emilylinchan/led-spectrum/assets/flowchart.png

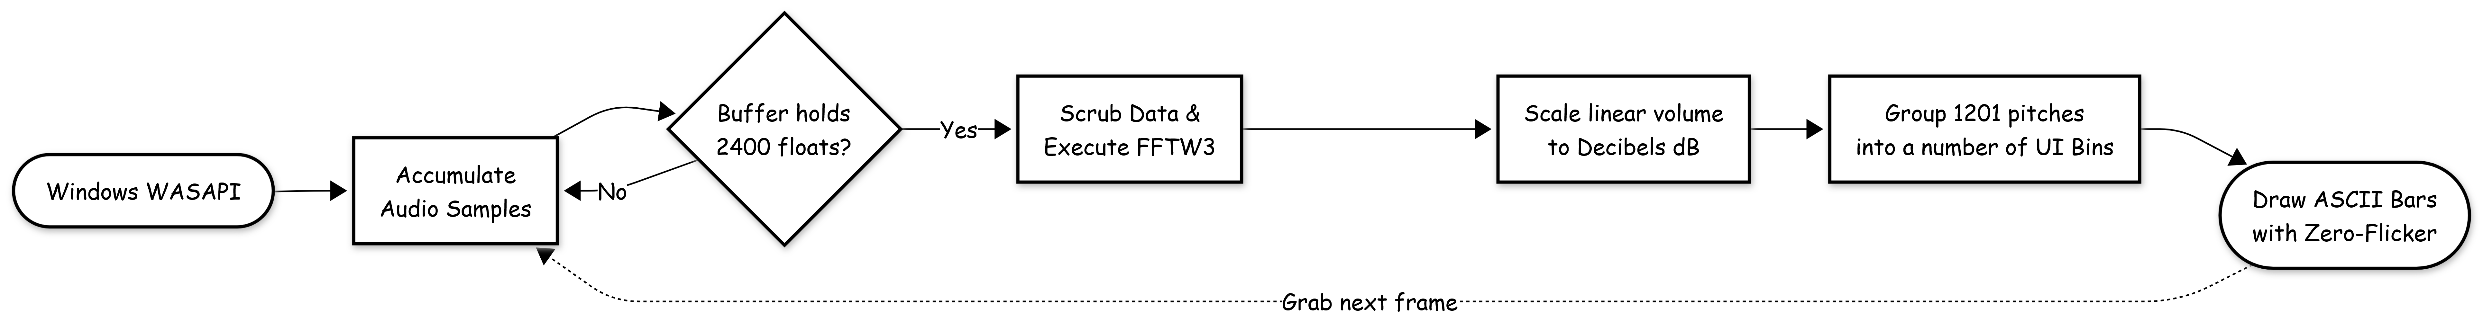
assets/flowchart.png
