emilylinchan/led-spectrum/assets/spectrum.gif

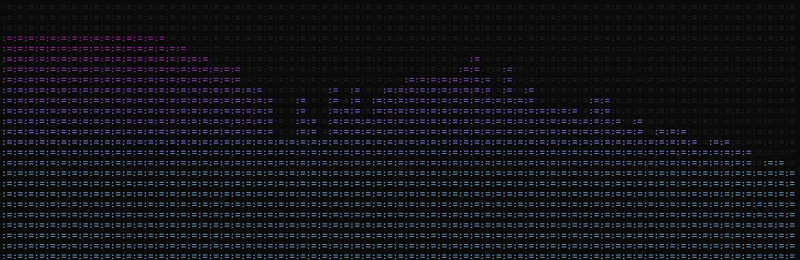
assets/spectrum.gif
