emilylinchan/led-spectrum/assets/spectrum.png

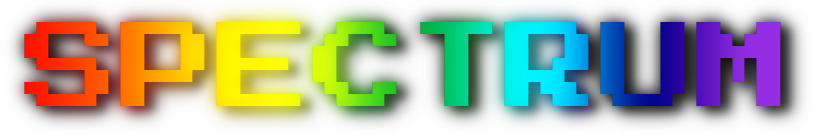
assets/spectrum.png
