emilylinchan/led-spectrum/hardware/images/custom_cable.png

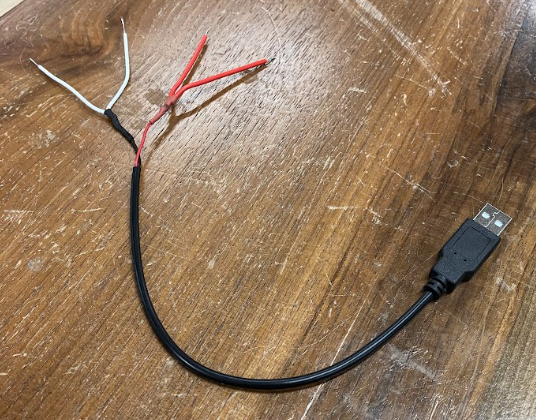
hardware/images/custom_cable.png
