emilylinchan/led-spectrum/(list of files, cad)

Other CAD files:
hardware/cad/led_spectrum_frame.ipt
