emilylinchan/led-spectrum/hardware/images/wiring_setup.png

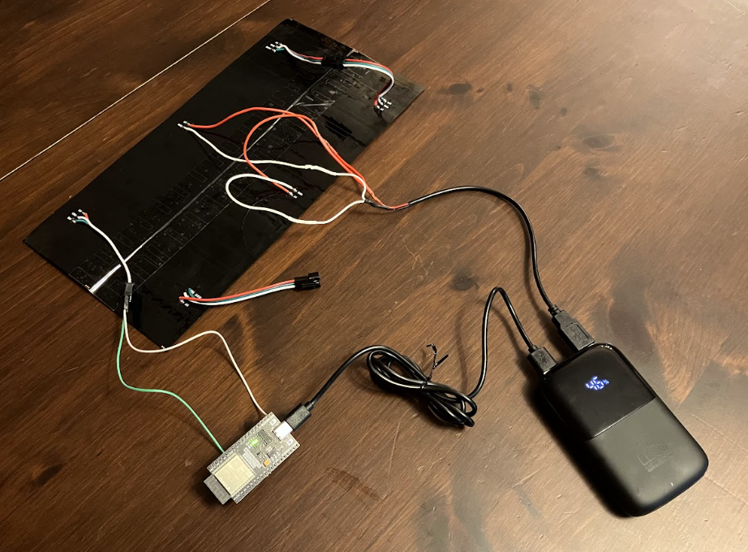
hardware/images/wiring_setup.png
