emilylinchan/led-spectrum/assets/discrete fast fourier transforms.pdf

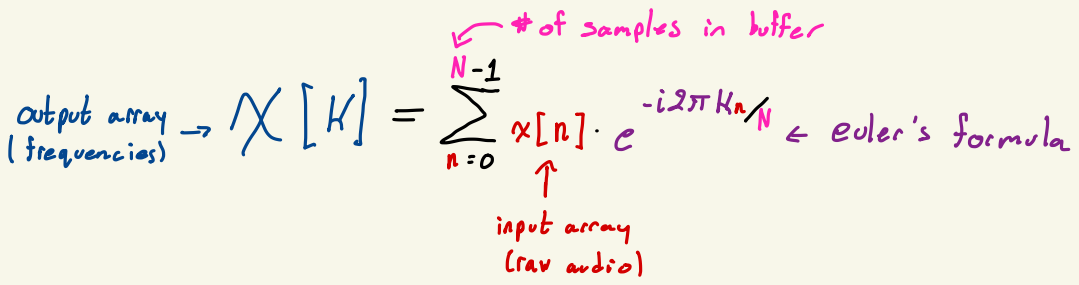
[picture p7: page 1]
## of samples in; buffer; outpet aray; requncia¹ → A ( N; ierthnN =; euler's formula; input array craw audiol
