emilylinchan/led-spectrum/src/main.cpp

/*
    Terminal Equalizer - A real-time command line audio visualizer
    Copyright (C) 2026 Majock Bim

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
    You should have received a copy of the GNU General Public License
    along with this program.  If not, see <https://www.gnu.org/licenses/>.
*/

#include "../inc/main.hpp"

#define AsciiRgb(k, r, g, b) "\033[" #k ";2;" #r ";" #g ";" #b "m"

std::atomic<bool> keepRunning(true);

void signalHandler(_In_ int signum) {
    keepRunning = false;
    AudioEngine::Get().Stop();
}

int __cdecl main(void) {
    SetConsoleOutputCP(CP_UTF8);
    SetConsoleTitleA("Initializing...");

    HINSTANCE hInstance = GetModuleHandle(NULL);
    HWND ConsoleWindow = GetConsoleWindow();

    HICON hIcon = LoadIcon(hInstance, MAKEINTRESOURCE(100)); // 100 = icon.ico
    if (hIcon) {
        SendMessage(ConsoleWindow, WM_SETICON, ICON_BIG, (LPARAM)hIcon);
        SendMessage(ConsoleWindow, WM_SETICON, ICON_SMALL, (LPARAM)hIcon);
    }
    
    // register signal handler for clean exit
    signal(SIGINT, signalHandler);

    SignalProcessor signal;
    FFTEngine fft;
    RenderEqualizer equalizer;

    std::mutex magMutex;
    std::vector<double> sharedMagnitudes;
    std::vector<double> sharedWaveform;

    std::thread t1([&]() {
        CoInitialize(NULL);
        while (keepRunning) {
            signal.Accumulate();
            
            // Process all available windows to catch up
            while (signal.isFull() && keepRunning) {
                auto pass = signal.GetFFTBuffer();
                auto magnitudes = fft.Run(pass);
                std::lock_guard<std::mutex> lock(magMutex);
                sharedMagnitudes = magnitudes;
                sharedWaveform.assign(pass.begin(), pass.end());
            }
            
            std::this_thread::sleep_for(std::chrono::milliseconds(5));
        }
        CoUninitialize();
    });

    std::thread t2([&]() {
        CoInitialize(NULL);
        int sampleRate = AudioEngine::Get().GetSampleRate();
        JsonFileFinder jsonFileFinder;
        JsonFileReader jsonFileReader;

        jsonFileFinder.FindJsonFiles(&jsonFileReader);
        SetConsoleTitleA("SPECTRUM");
        equalizer.EnableVisualizer(sharedMagnitudes, sharedWaveform, magMutex, sampleRate, jsonFileReader);
        CoUninitialize();
    });

    t1.join();
    t2.join();

    return 0;
}
