emilylinchan/led-spectrum/(commit log)

2026-04-21 Add flowchart section to README
    Added flowchart image to README for better visualization.
2026-05-24 feat: add oscillator + make needed fixes
    [fft.cpp, main.cpp, settings.cpp, signal_processor.cpp, visualizer.cpp]
2026-05-24 fix: theme changes not working
    [visualizer.cpp]
2026-05-24 chore: update noise floor, gamma contrast, correct bass, add smoother falloff, & steady baseline
    [visualizer.cpp]
2026-05-24 fix: ensure C++17 compatability + finalize tuning state, etc..
    [settings.cpp, visualizer.cpp]
2026-05-24 look here to customize your visualizer 🎉
2026-05-24 look here to customize your visualizer ٩(^ᗜ^ )و ´-
2026-05-24 look here for custom theme templates (◉ _ ◉)
2026-05-24 fix: smoother theme transitioning
    [visualizer.cpp]
2026-05-24 chore: swap main themes
    [settings.cpp]
2026-06-08 feat: add 'V' key switch for AGC visualization modes
    - Implement key handling for 'V' to switch disableVolScaling mode.
    - Add TODO stubs for FFT dynamic noise floor and oscilloscope normalization.
    [visualizer.cpp]
2026-06-13 feat:Add FFT dynamic noise floor and oscilloscope normalization
    [visualizer.cpp]
2026-06-15 fix: clean up V key volume scaling toggle
    [visualizer.cpp]
2026-06-18 cool people ദ്ദി・ᴗ・)✧
2026-07-10 Added standalone LED panel test
2026-07-19 docs: fix BOM component links
2026-07-21 docs: replace video demo link with YT url
    [led_spectrum_frame.ipt]
